hridcode/polaris/production/pnp-assembly/bom.csv

Designator | Footprint | Quantity | Value | LCSC Part #
BT1 | CR1220_Battery_Holder | 1 | Battery_Cell | C964723
C1, C2, C3 | 0402 | 3 | 4.7uF | C23733
C10, C23, C24, C25, C26, C27, C9 | 0402 | 7 | 10uF | C15525
C11, C21, C22 | 0603 | 3 | 22uF | C59461
C12, C13, C14, C15, C16, C17, C18, C19, C20, C28, C6, C7, C8 | 0402 | 13 | 0.1uF | C1525
C4, C5 | 0402 | 2 | 20pF | C1554
D1, D10, D11, D12, D2, D3, D4, D5, D6, D7, D8, D9 | SOT-363_SC-70-6 | 12 | BAW56S | C426776
J1 | USB_C_Receptacle_HRO_TYPE-C-31-M-12 | 1 | USB_C_Receptacle_USB2.0_14P | C165948
J2 | HDMI_A_Molex_208658-1001_Horizontal | 1 | HDMI_A | C720616
J3 | PinSocket_1x05_P2.54mm_Horizontal | 1 | Conn_01x05
J4 | PinSocket_2x07_P2.54mm_Horizontal | 1 | Conn_02x07_Odd_Even
J5 | TF-SMD_TF-CARD-H1.8 | 1 | Micro_SD_Card_Det1 | C7529389
J6 | JST_PH_B2B-PH-K_1x02_P2.00mm_Vertical | 1 | Conn_01x02
L1 | 0402 | 1 | 3.3uH | C84474
L2 | 0402 | 1 | 1uH | C84468
LS1 | PinSocket_1x02_P2.54mm_Vertical | 1 | Speaker
R1, R2 | 0402 | 2 | 5.1K | C25905
R10, R11, R12, R13, R14, R15, R16, R17 | 0603 | 8 | 220 | C22962
R18, R19 | 0402 | 2 | 4.7K | C25905
R20, R21, R22, R23, R24 | 0402 | 5 | 10K | C25905
R3, R4 | 0603 | 2 | 27 | C25190
R5 | 0402 | 1 | 33 | C25105
R6, R7 | 0402 | 2 | 1K | C11702
R8, R9 | 0603 | 2 | 2 | C22977
SW1, SW10, SW11, SW12, SW13, SW14, SW15, SW16, SW17, SW18, SW19, SW2, SW20, SW21, SW22, SW23, SW24, SW25, SW26, SW27, SW28, SW29, SW3, SW30, SW31, SW32, SW33, SW34, SW35, SW36, SW37, SW38, SW39, SW4, SW40, SW41, SW42, SW43, SW44, SW47, SW48, SW49, SW5, SW50, SW6, SW7, SW8, SW9 | SW-SMD_L4.0-W3.0-LS5.0 | 48 | SW_Push
SW45 | PinSocket_1x02_P2.54mm_Vertical | 1 | SW_SPST
SW51, SW52 | 1812 | 2 | SW_Push
U1 | TQFN-16-1EP_3x3mm_P0.5mm_EP1.23x1.23mm | 1 | MAX98357A | C910544
U2 | eSOP-8 | 1 | IP5306 | C181692
U3 | QFN-80-1EP_10x10mm_P0.4mm_EP3.4x3.4mm | 1 | RP2354B | C39843328
U4 | SOT-23-3 | 1 | XC6206PxxxMR | C5446
U5 | SOIC-8_3.9x4.9mm_P1.27mm | 1 | APS1604M-3SQRx-SN | C18214056
U6 | SOIC-8_3.9x4.9mm_P1.27mm | 1 | DS3231MZ | C107410
Y1 | Crystal_SMD_3225-4Pin_3.2x2.5mm | 1 | Crystal_GND24 | C9002
