hridcode/polaris/production/cad/key mat.step

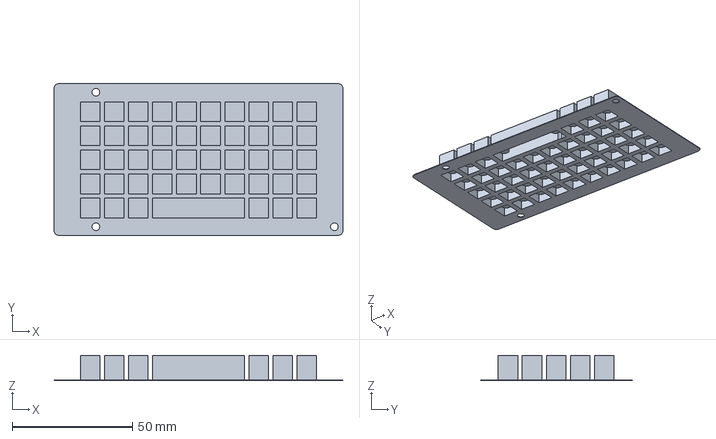
[picture p4: CAD file, 2026-10-04]
production/cad/key mat.step
120.0 x 63.0 x 10.5 mm
