hridcode/polaris/production/cad/top case.step

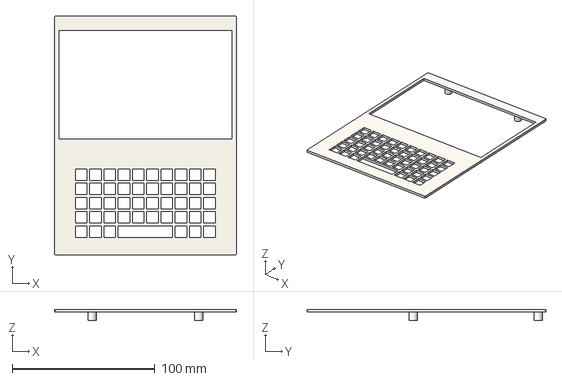
[picture p5: CAD file, 2026-10-04]
production/cad/top case.step
127.7 x 167.4 x 8.00 mm
