hridcode/polaris/production/cad/bottom case.step

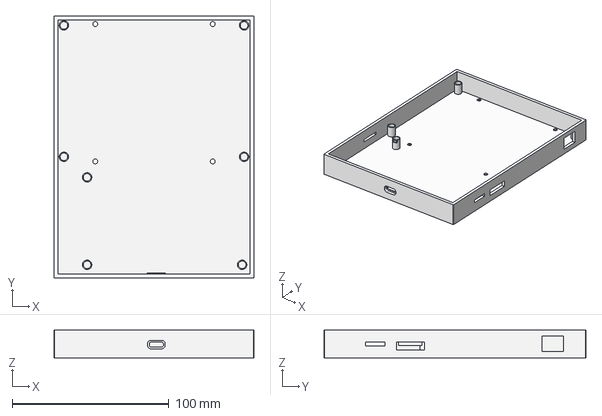
[picture p6: CAD file, 2026-10-04]
production/cad/bottom case.step
127.7 x 167.4 x 17.8 mm
