hridcode/polaris/(list of files, cad)

Other CAD files:
production/cad/assembly.step
