hridcode/polaris/source/pcb/polaris.kicad_pcb

## KiCad design source/pcb/polaris.kicad_pcb (2026-10-04)

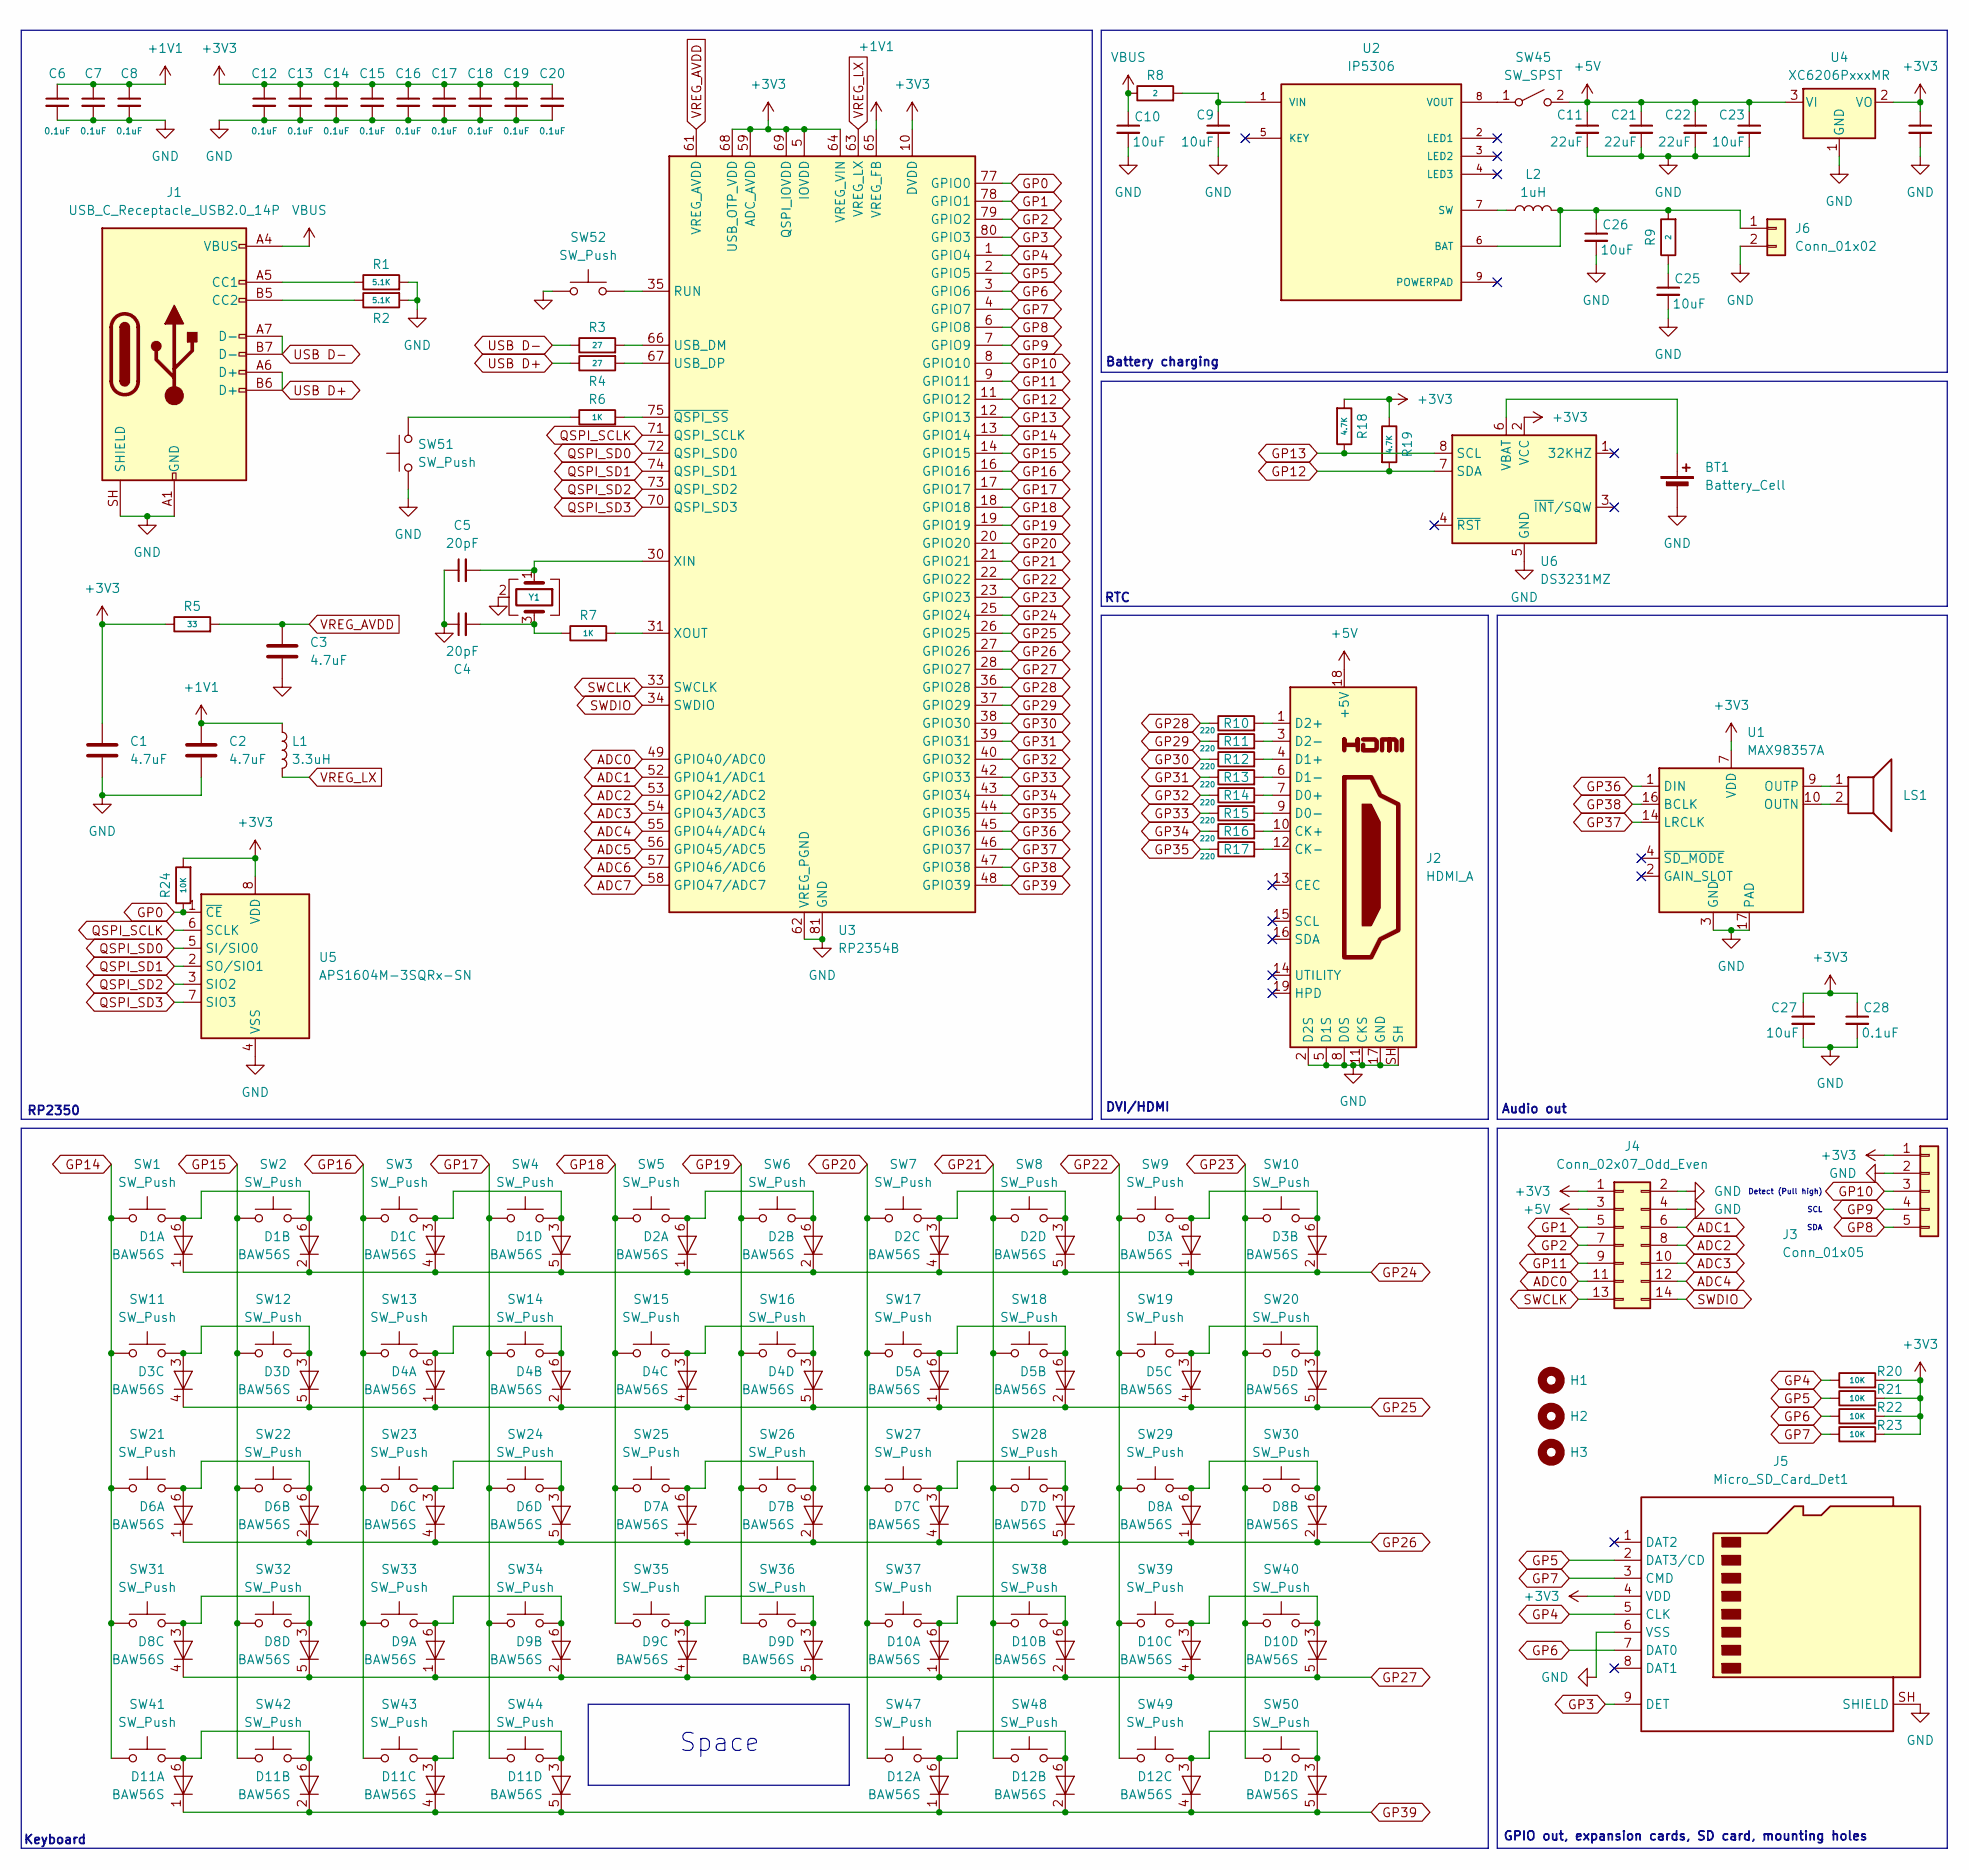
[picture p7: schematic polaris.kicad_sch]

Parts:
BT1: Battery_Cell; CR1220_Battery_Holder
C1, C2, C3: 4.7uF; C_0402_1005Metric; MPN C23733
C4, C5: 20pF; C_0402_1005Metric; MPN C1554
C6, C7, C8, C12, C13, C14, C15, C16, C17, C18, C19, C20, C28: 0.1uF; C_0402_1005Metric; MPN C1525
C9, C10, C23, C24, C25, C26, C27: 10uF; C_0402_1005Metric; MPN C15525
C11, C21, C22: 22uF; C_0603_1608Metric; MPN C59461
D1, D2, D3, D4, D5, D6, D7, D8, D9, D10, D11, D12: BAW56S; SOT-363_SC-70-6
H1, H2, H3: MountingHole; MountingHole_3.2mm_M3
J1: USB_C_Receptacle_USB2.0_14P; USB_C_Receptacle_HRO_TYPE-C-31-M-12; MPN C165948
J2: HDMI_A; HDMI_A_Molex_208658-1001_Horizontal
J3: Conn_01x05; PinSocket_1x05_P2.54mm_Horizontal
J4: Conn_02x07_Odd_Even; PinSocket_2x07_P2.54mm_Horizontal
J5: Micro_SD_Card_Det1; TF-SMD_TF-CARD-H1.8
J6: Conn_01x02; JST_PH_B2B-PH-K_1x02_P2.00mm_Vertical
L1: 3.3uH; L_0402_1005Metric; MPN C84474
L2: 1uH; L_0402_1005Metric; MPN C84468
LS1: Speaker; PinSocket_1x02_P2.54mm_Vertical
R1, R2: 5.1K; R_0402_1005Metric; MPN C25905
R3, R4: 27; R_0603_1608Metric; MPN C25190
R5: 33; R_0402_1005Metric; MPN C25105
R6, R7: 1K; R_0402_1005Metric; MPN C11702
R8, R9: 2; R_0603_1608Metric; MPN C22977
R10, R11, R12, R13, R14, R15, R16, R17: 220; R_0603_1608Metric; MPN C22977
R18, R19: 4.7K; R_0402_1005Metric; MPN C25905
R20, R21, R22, R23, R24: 10K; R_0402_1005Metric; MPN C25905
SW1, SW2, SW3, SW4, SW5, SW6, SW7, SW8, SW9, SW10, SW11, SW12, SW13, SW14, SW15, SW16, SW17, SW18, SW19, SW20, SW21, SW22, SW23, SW24, SW25, SW26, SW27, SW28, SW29, SW30, SW31, SW32, SW33, SW34, SW35, SW36, SW37, SW38, SW39, SW40, SW41, SW42, SW43, SW44, SW47, SW48, SW49, SW50: SW_Push; SW-SMD_L4.0-W3.0-LS5.0
SW45: SW_SPST; PinSocket_1x02_P2.54mm_Vertical
SW51, SW52: SW_Push; R_1812_4532Metric
U1: MAX98357A; TQFN-16-1EP_3x3mm_P0.5mm_EP1.23x1.23mm
U2: IP5306; eSOP-8; PARTREV 1.31
U3: RP2354B; QFN-80-1EP_10x10mm_P0.4mm_EP3.4x3.4mm; MPN C39843328
U4: XC6206PxxxMR; SOT-23-3; MPN C5446
U5: APS1604M-3SQRx-SN; SOIC-8_3.9x4.9mm_P1.27mm
U6: DS3231MZ; SOIC-8_3.9x4.9mm_P1.27mm
Y1: Crystal_GND24; Crystal_SMD_3225-4Pin_3.2x2.5mm; MPN C9002

Connections:
+1V1: C2.1, C6.1, C7.1, C8.1, L1.1, U3.65 (VREG_FB)
+3V3: C1.1, C12.1, C13.1, C14.1, C15.1, C16.1, C17.1, C18.1, C19.1, C20.1, C24.1, C27.1, C28.1, J3.1, J4.1, J5.4 (VDD), R5.1, R18.2, R19.1, R20.2, R21.2, R22.2, R23.2, R24.2, U1.7 (VDD), U1.8 (VDD), U3.5 (IOVDD), U3.10 (DVDD), U3.15 (IOVDD), U3.24 (IOVDD), U3.29 (IOVDD), U3.32 (DVDD), U3.41 (IOVDD), U3.50 (IOVDD), U3.51 (DVDD), U3.59 (ADC_AVDD), U3.60 (IOVDD), U3.64 (VREG_VIN), U3.68 (USB_OTP_VDD), U3.69 (QSPI_IOVDD), U3.76 (IOVDD), U4.2 (VO), U5.8 (VDD), U6.2 (VCC)
+5V: C11.1, C21.1, C22.1, C23.1, J2.18 (+5V), J4.3, SW45.2 (B), U4.3 (VI)
ADC0: J4.11, U3.49 (GPIO40/ADC0)
ADC1: J4.6, U3.52 (GPIO41/ADC1)
ADC2: J4.8, U3.53 (GPIO42/ADC2)
ADC3: J4.10, U3.54 (GPIO43/ADC3)
ADC4: J4.12, U3.55 (GPIO44/ADC4)
ADC5: U3.56 (GPIO45/ADC5)
ADC6: U3.57 (GPIO46/ADC6)
ADC7: U3.58 (GPIO47/ADC7)
GND: BT1.2 (-), C1.2, C2.2, C3.2, C4.1, C5.1, C6.2, C7.2, C8.2, C9.2, C10.2, C11.2, C12.2, C13.2, C14.2, C15.2, C16.2, C17.2, C18.2, C19.2, C20.2, C21.2, C22.2, C23.2, C24.2, C25.2, C26.2, C27.2, C28.2, J1.A1 (GND), J1.A12 (GND), J1.B1 (GND), J1.B12 (GND), J1.SH (SHIELD), J2.2 (D2S), J2.5 (D1S), J2.8 (D0S), J2.11 (CKS), J2.17 (GND), J2.SH, J3.2, J4.2, J4.4, J5.6 (VSS), J5.SH (SHIELD), J6.2, R1.2, R2.2, SW51.1, SW52.1, U1.3 (GND), U1.11 (GND), U1.15 (GND), U1.17 (PAD), U3.62 (VREG_PGND), U3.81 (GND), U4.1 (GND), U5.4 (VSS), U6.5 (GND), Y1.2 (G), Y1.4 (G)
GP0: R24.1, U3.77 (GPIO0), U5.1 (~CE)
GP1: J4.5, U3.78 (GPIO1)
GP2: J4.7, U3.79 (GPIO2)
GP3: J5.9 (DET), U3.80 (GPIO3)
GP4: J5.5 (CLK), R20.1, U3.1 (GPIO4)
GP5: J5.2 (DAT3/CD), R21.1, U3.2 (GPIO5)
GP6: J5.7 (DAT0), R22.1, U3.3 (GPIO6)
GP7: J5.3 (CMD), R23.1, U3.4 (GPIO7)
GP8: J3.5, U3.6 (GPIO8)
GP9: J3.4, U3.7 (GPIO9)
GP10: J3.3, U3.8 (GPIO10)
GP11: J4.9, U3.9 (GPIO11)
GP12: R19.2, U3.11 (GPIO12), U6.7 (SDA)
GP13: R18.1, U3.12 (GPIO13), U6.8 (SCL)
GP14: SW1.1, SW11.1, SW21.1, SW31.1, SW41.1, U3.13 (GPIO14)
GP15: SW2.1, SW12.1, SW22.1, SW32.1, SW42.1, U3.14 (GPIO15)
GP16: SW3.1, SW13.1, SW23.1, SW33.1, SW43.1, U3.16 (GPIO16)
GP17: SW4.1, SW14.1, SW24.1, SW34.1, SW44.1, U3.17 (GPIO17)
GP18: SW5.1, SW15.1, SW25.1, SW35.1, U3.18 (GPIO18)
GP19: SW6.1, SW16.1, SW26.1, SW36.1, U3.19 (GPIO19)
GP20: SW7.1, SW17.1, SW27.1, SW37.1, SW47.1, U3.20 (GPIO20)
GP21: SW8.1, SW18.1, SW28.1, SW38.1, SW48.1, U3.21 (GPIO21)
GP22: SW9.1, SW19.1, SW29.1, SW39.1, SW49.1, U3.22 (GPIO22)
GP23: SW10.1, SW20.1, SW30.1, SW40.1, SW50.1, U3.23 (GPIO23)
GP24: D1.1 (K), D1.2 (K), D1.4 (K), D1.5 (K), D2.1 (K), D2.2 (K), D2.4 (K), D2.5 (K), D3.1 (K), D3.2 (K), U3.25 (GPIO24)
GP25: D3.4 (K), D3.5 (K), D4.1 (K), D4.2 (K), D4.4 (K), D4.5 (K), D5.1 (K), D5.2 (K), D5.4 (K), D5.5 (K), U3.26 (GPIO25)
GP26: D6.1 (K), D6.2 (K), D6.4 (K), D6.5 (K), D7.1 (K), D7.2 (K), D7.4 (K), D7.5 (K), D8.1 (K), D8.2 (K), U3.27 (GPIO26)
GP27: D8.4 (K), D8.5 (K), D9.1 (K), D9.2 (K), D9.4 (K), D9.5 (K), D10.1 (K), D10.2 (K), D10.4 (K), D10.5 (K), U3.28 (GPIO27)
GP28: R10.1, U3.36 (GPIO28)
GP29: R11.1, U3.37 (GPIO29)
GP30: R12.1, U3.38 (GPIO30)
GP31: R13.1, U3.39 (GPIO31)
GP32: R14.1, U3.40 (GPIO32)
GP33: R15.1, U3.42 (GPIO33)
GP34: R16.1, U3.43 (GPIO34)
GP35: R17.1, U3.44 (GPIO35)
GP36: U1.1 (DIN), U3.45 (GPIO36)
GP37: U1.14 (LRCLK), U3.46 (GPIO37)
GP38: U1.16 (BCLK), U3.47 (GPIO38)
GP39: D11.1 (K), D11.2 (K), D11.4 (K), D11.5 (K), D12.1 (K), D12.2 (K), D12.4 (K), D12.5 (K), U3.48 (GPIO39)
unnamed: BT1.1 (+), U6.6 (VBAT)
unnamed: C4.2, R7.1, Y1.3
unnamed: C25.1, R9.1
unnamed: D1.6 (A), SW1.2, SW2.2
unnamed: D1.3 (A), SW3.2, SW4.2
unnamed: D2.6 (A), SW5.2, SW6.2
unnamed: D2.3 (A), SW7.2, SW8.2
unnamed: D3.6 (A), SW9.2, SW10.2
unnamed: D3.3 (A), SW11.2, SW12.2
unnamed: D4.6 (A), SW13.2, SW14.2
unnamed: D4.3 (A), SW15.2, SW16.2
unnamed: D5.6 (A), SW17.2, SW18.2
unnamed: D5.3 (A), SW19.2, SW20.2
unnamed: D6.6 (A), SW21.2, SW22.2
unnamed: D6.3 (A), SW23.2, SW24.2
unnamed: D7.6 (A), SW25.2, SW26.2
unnamed: D7.3 (A), SW27.2, SW28.2
unnamed: D8.6 (A), SW29.2, SW30.2
unnamed: D8.3 (A), SW31.2, SW32.2
unnamed: D9.6 (A), SW33.2, SW34.2
unnamed: D9.3 (A), SW35.2, SW36.2
unnamed: D10.6 (A), SW37.2, SW38.2
unnamed: D10.3 (A), SW39.2, SW40.2
unnamed: D11.6 (A), SW41.2, SW42.2
unnamed: D11.3 (A), SW43.2, SW44.2
unnamed: D12.6 (A), SW47.2, SW48.2
unnamed: D12.3 (A), SW49.2, SW50.2
unnamed: J1.A5 (CC1), R1.1
unnamed: J1.B5 (CC2), R2.1
unnamed: J2.10 (CK+), R16.2
unnamed: J2.12 (CK-), R17.2
unnamed: J2.7 (D0+), R14.2
unnamed: J2.9 (D0-), R15.2
unnamed: J2.4 (D1+), R12.2
unnamed: J2.6 (D1-), R13.2
unnamed: J2.1 (D2+), R10.2
unnamed: J2.3 (D2-), R11.2
unnamed: C26.1, J6.1, L2.2, R9.2, U2.6 (BAT)
unnamed: R6.1, SW51.2
unnamed: SW45.1 (A), U2.8 (VOUT)
unnamed: LS1.2, U1.10 (OUTN)
unnamed: LS1.1, U1.9 (OUTP)
unnamed: L2.1, U2.7 (SW)
unnamed: C9.1, R8.2, U2.1 (VIN)
unnamed: SW52.2, U3.35 (RUN)
unnamed: R3.2, U3.66 (USB_DM)
unnamed: R4.2, U3.67 (USB_DP)
unnamed: C5.2, U3.30 (XIN), Y1.1
unnamed: R7.2, U3.31 (XOUT)
unnamed: R6.2, U3.75 (~QSPI_SS)
QSPI_SCLK: U3.71 (QSPI_SCLK), U5.6 (SCLK)
QSPI_SD0: U3.72 (QSPI_SD0), U5.5 (SI/SIO0)
QSPI_SD1: U3.74 (QSPI_SD1), U5.2 (SO/SIO1)
QSPI_SD2: U3.73 (QSPI_SD2), U5.3 (SIO2)
QSPI_SD3: U3.70 (QSPI_SD3), U5.7 (SIO3)
SWCLK: J4.13, U3.33 (SWCLK)
SWDIO: J4.14, U3.34 (SWDIO)
USB D+: J1.A6 (D+), J1.B6 (D+), R4.1
USB D-: J1.A7 (D-), J1.B7 (D-), R3.1
VBUS: C10.1, J1.A4 (VBUS), J1.A9 (VBUS), J1.B4 (VBUS), J1.B9 (VBUS), R8.1
VREG_AVDD: C3.1, R5.2, U3.61 (VREG_AVDD)
VREG_LX: L1.2, U3.63 (VREG_LX)

Notes on the sheet:
RTC
Keyboard
SDA
Battery charging
Detect (Pull high)
Audio out
SCL
Space
RP2350
GPIO out, expansion cards, SD card, mounting holes
DVI/HDMI

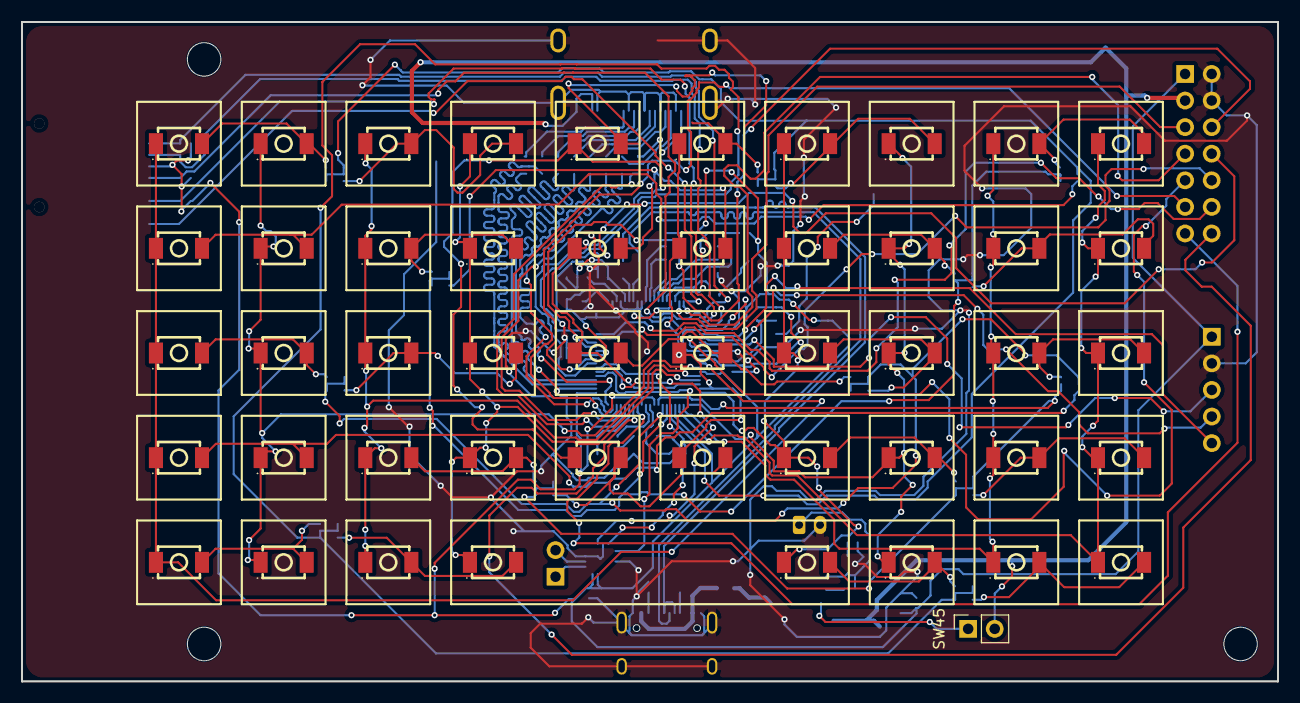
[picture p8: board polaris.kicad_pcb from above]

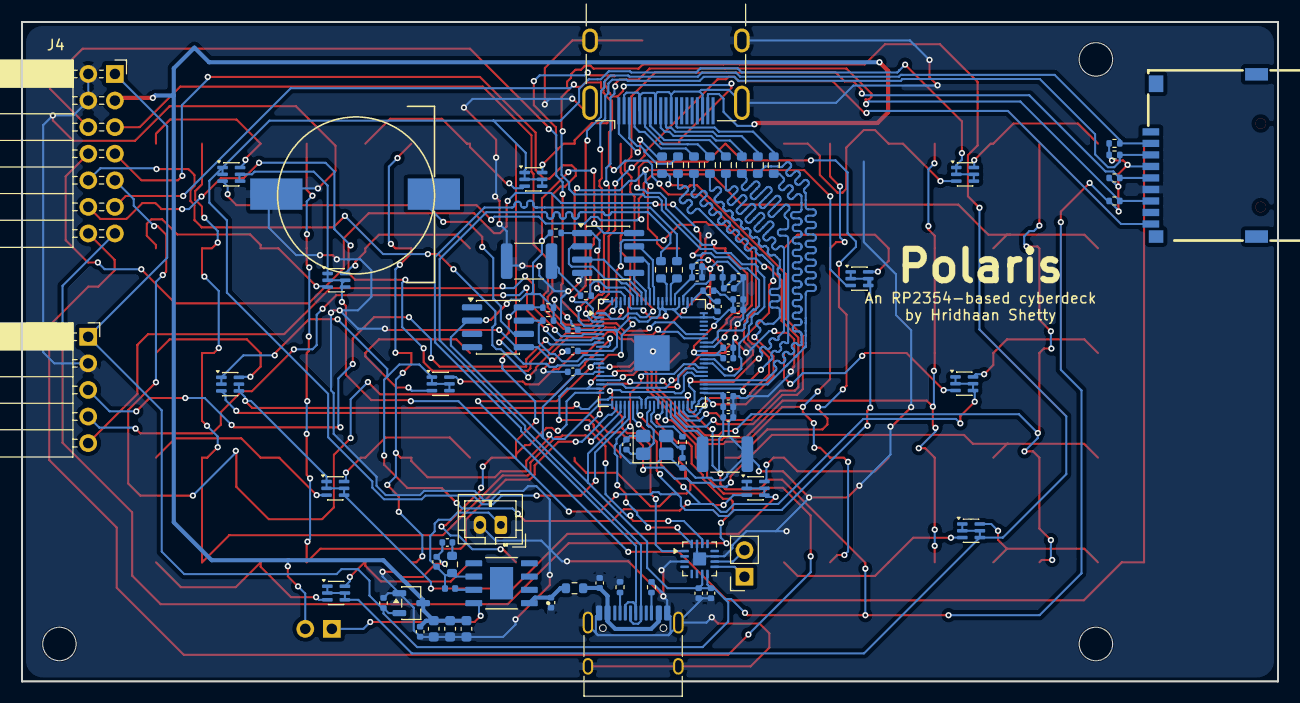
[picture p9: board polaris.kicad_pcb from below]

Board: 2 copper layers, 120.0 x 63.0 mm, 135 parts (83 on the bottom side), 111 nets.
